patthananb/ECE_Openhouse_Souvenir/docs/placement_bottom.png

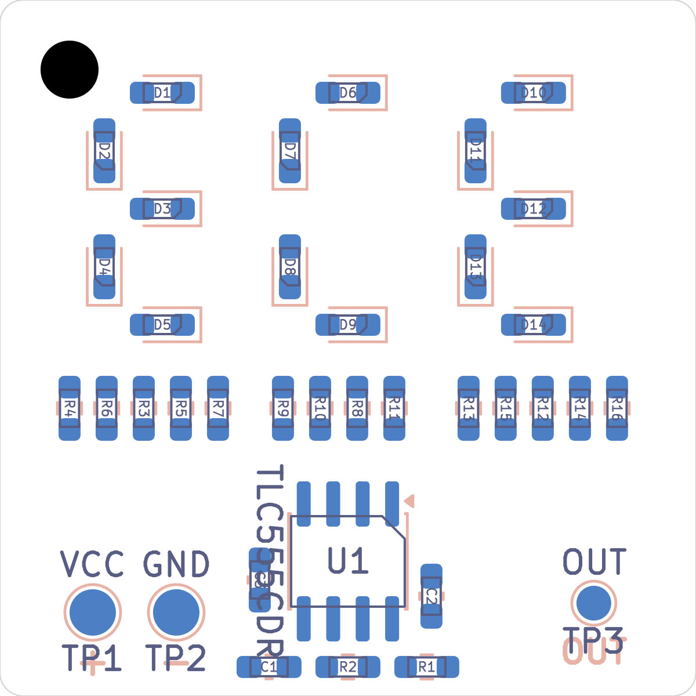
docs/placement_bottom.png
