patthananb/ECE_Openhouse_Souvenir/docs/placement_top.png

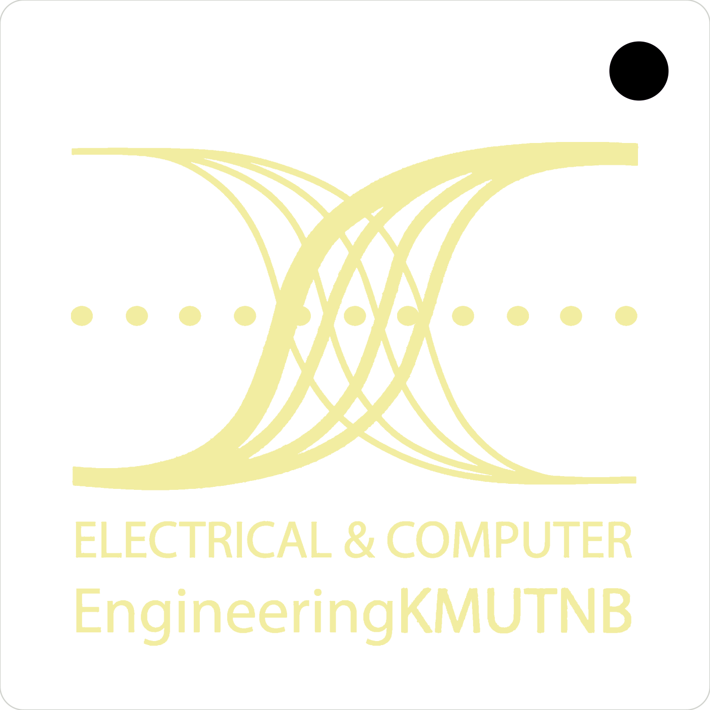
docs/placement_top.png
