patthananb/ECE_Openhouse_Souvenir/docs/routed_bottom.png

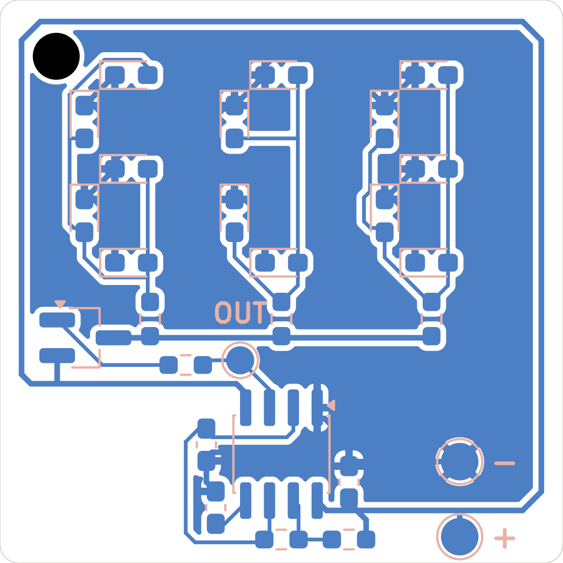
docs/routed_bottom.png
