patthananb/ECE_Openhouse_Souvenir/hardware/ece_souvenir.kicad_pcb

## KiCad design hardware/ece_souvenir.kicad_pcb (2026-10-12)

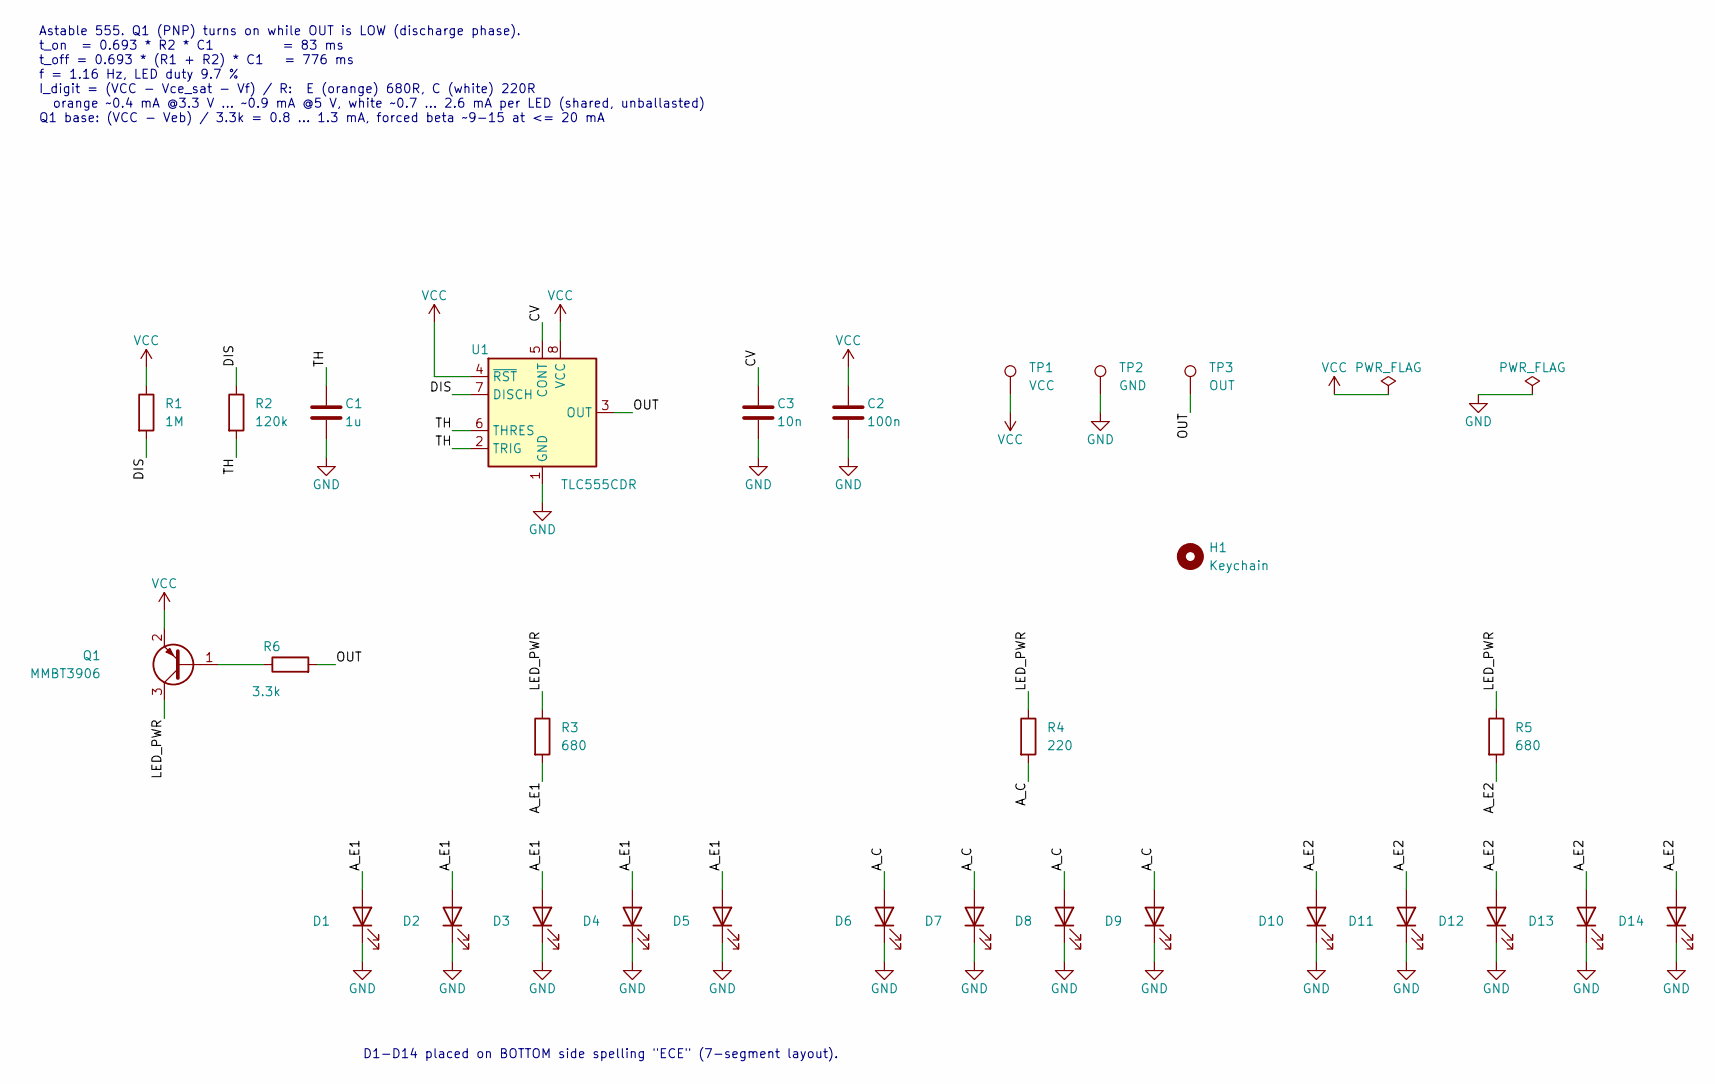
[picture p4: schematic ece_souvenir.kicad_sch, KMUTNB ECE Souvenir - ECE blinker]

Parts:
C1: 1u; C_0603_1608Metric_Pad1.08x0.95mm_HandSolder; MPN CC0603KRX7R7BB105; LCSC C106248
C2: 100n; C_0603_1608Metric_Pad1.08x0.95mm_HandSolder; MPN CC0603KRX7R9BB104; LCSC C14663
C3: 10n; C_0603_1608Metric_Pad1.08x0.95mm_HandSolder; MPN 0603B103K500NT; LCSC C57112
D1, D2, D3, D4, D5, D10, D11, D12, D13, D14: Orange; LED_0603_1608Metric_Pad1.05x0.95mm_HandSolder; MPN XL-1608UOC-06; LCSC C965800
D6, D7, D8, D9: White; LED_0603_1608Metric_Pad1.05x0.95mm_HandSolder; MPN XL-1608UWC-04; LCSC C965808
H1: Keychain; MountingHole_2.5mm
Q1: MMBT3906; SOT-23_Handsoldering; MPN MMBT3906LT1G; LCSC C53444
R1: 1M; R_0603_1608Metric_Pad0.98x0.95mm_HandSolder; MPN 0603WAF1004T5E; LCSC C22935
R2: 120k; R_0603_1608Metric_Pad0.98x0.95mm_HandSolder; MPN 0603WAF1203T5E; LCSC C25808
R3, R5: 680; R_0603_1608Metric_Pad0.98x0.95mm_HandSolder; MPN 0603WAF6800T5E; LCSC C23228
R4: 220; R_0603_1608Metric_Pad0.98x0.95mm_HandSolder; MPN 0603WAF2200T5E; LCSC C22962
R6: 3.3k; R_0603_1608Metric_Pad0.98x0.95mm_HandSolder; MPN 0603WAF3301T5E; LCSC C22978
TP1: VCC; TestPoint_Pad_D2.0mm
TP2: GND; TestPoint_Pad_D2.0mm
TP3: OUT; TestPoint_Pad_D1.5mm
U1: TLC555CDR; SOIC-8_3.9x4.9mm_P1.27mm; MPN TLC555CDR; LCSC C6986

Connections:
/A_C: D6.2 (A), D7.2 (A), D8.2 (A), D9.2 (A), R4.2
/A_E1: D1.2 (A), D2.2 (A), D3.2 (A), D4.2 (A), D5.2 (A), R3.2
/A_E2: D10.2 (A), D11.2 (A), D12.2 (A), D13.2 (A), D14.2 (A), R5.2
/CV: C3.1, U1.5 (CONT)
/DIS: R1.2, R2.1, U1.7 (DISCH)
/LED_PWR: Q1.3 (C), R3.1, R4.1, R5.1
/OUT: R6.2, TP3.1, U1.3 (OUT)
/TH: C1.1, R2.2, U1.2 (TRIG), U1.6 (THRES)
GND: C1.2, C2.2, C3.2, D1.1 (K), D2.1 (K), D3.1 (K), D4.1 (K), D5.1 (K), D6.1 (K), D7.1 (K), D8.1 (K), D9.1 (K), D10.1 (K), D11.1 (K), D12.1 (K), D13.1 (K), D14.1 (K), TP2.1, U1.1 (GND)
unnamed: Q1.1 (B), R6.1
VCC: C2.1, Q1.2 (E), R1.1, TP1.1, U1.4 (~RST), U1.8 (VCC)

Notes on the sheet:
Astable 555. Q1 (PNP) turns on while OUT is LOW (discharge phase). t_on = 0.693 * R2 * C1 = 83 ms t_off = 0.693 * (R1 + R2) * C1 = 776 ms f = 1.16 Hz, LED duty 9.7 % I_digit = (VCC - Vce_sat - Vf) / R: E (orange) 680R, C (white) 220R orange ~0.4 mA @3.3 V ... ~0.9 mA @5 V, white ~0.7 ... 2.6 mA per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
D1-D14 placed on BOTTOM side spelling "ECE" (7-segment layout).

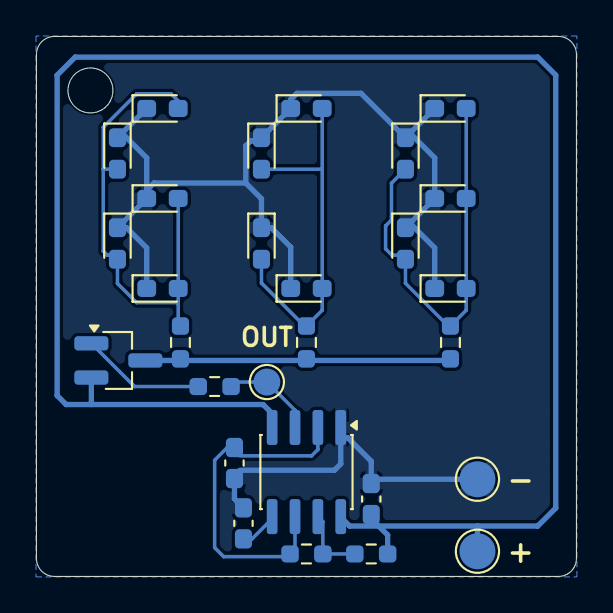
[picture p5: board ece_souvenir.kicad_pcb from below]

Board: 2 copper layers, 30.0 x 30.0 mm, 29 parts (28 on the bottom side), 11 nets.
