patthananb/ECE_Openhouse_Souvenir/(commit log)

2026-10-09 feat(sch): CMOS 555 blinker schematic with 14 LED branches
    Schematic generated from tools/parts.py by tools/gen_sch.py, upgraded
    to KiCad 10 format. ERC: 0 errors, 0 warnings. Netlist verified against
    spec by tools/check_netlist.py.
    Default parts (pending confirmation): TLC555CDR C6986, XL-1005UOC
    C965791, C1 CC0603KRX7R7BB105 C106248.
    [ece_souvenir.kicad_sch]
2026-10-09 feat(sch): pick C1 basic X5R part, add keychain hole H1, add logo art
    C1 -> C52923 (1uF 25V X5R 0402, JLC basic) instead of extended X7R to
    avoid a loading fee; temp range irrelevant for a souvenir. H1 2.5 mm
    NPTH keychain hole added so board and schematic stay in parity.
    art/ece_logo.png is the source raster for the top silkscreen.
    [ece_souvenir.kicad_sch]
2026-10-09 feat(pcb): board outline, keychain hole, logo silk and bottom placement
    30x30 mm R1 outline, 2.5 mm NPTH at (27,3). Logo traced from
    art/ece_logo.png into 48 F.SilkS polygons (24 x 21.3 mm). All parts on
    bottom: LEDs per spec 7-segment table (x mirrored), series resistors
    parallel to each LED, U1 at 270 deg with C2 1.96 mm from pin 8.
    JLCPCB rules and Power net class written to .kicad_pro.
    DRC: 0 violations, 0 parity issues, 57 unconnected (routing pending).
    [ece_souvenir.kicad_pcb, ece_souvenir.kicad_sch]
2026-10-09 feat(pcb): switch to 0603 hand-solder parts and re-place
    All parts will be hand soldered, so nothing smaller than 0603: LEDs
    XL-1608UOC-06 (C965800), passives 0603 with KiCad HandSolder footprints.
    C1 back to X7R (Yageo C106248) per the original spec now that JLC
    basic/extended fees no longer apply. Series resistors moved inside each
    digit to fit the larger 0603 courtyards.
    ERC 0, netlist OK. DRC: 0 violations, 0 parity, 57 unconnected (routing
    pending).
    [ece_souvenir.kicad_pcb, ece_souvenir.kicad_sch]
2026-10-09 feat(pcb): standalone LEDs, series resistors in a row below digits
    Per request, LEDs stand alone in the digit area. R3-R16 move to a single
    row of vertical 0603s at y=17.6 (bottom view), grouped per digit; U1 and
    timing parts shift down to the bottom edge.
    DRC: 0 violations, 0 parity, 57 unconnected (routing next).
    [ece_souvenir.kicad_pcb]
2026-10-09 feat(pcb): autoroute via Konnect + Freerouting, DRC clean
    KiCad native DSN export (bottom-side parts, roundrect pads and arc
    corners are outside Konnect's own Specctra profile) -> Konnect
    route_specctra_dsn (local Freerouting 2.4.1, JRE 25) -> KiCad SES import.
    DSN boundary inset 0.1 mm for the 0.3 mm edge rule; top-layer traces
    weighted 4-6x so the logo side carries only crossings. Freerouting
    neck-downs (0.15 mm) widened back to net-class width.
    Result: 267 mm B.Cu, 59.5 mm F.Cu, 14 tented vias.
    DRC: 0 violations, 0 unconnected, 0 schematic parity issues.
    [ece_souvenir.kicad_pcb]
2026-10-09 feat(pcb): single-sided routing, logo side copper-free
    All 334.9 mm of track on B.Cu with the parts: no F.Cu traces, no vias,
    so the top shows only the logo on white mask.
    - LED polarity 180 deg (a/g/d) / 270 deg (f/e) instead of spec 0/90:
    same look, but all cathodes meet at each digit's inner-left corner so
    sink and anode paths nest without crossing on one layer.
    - Resistor row reordered f e d g a per digit to match.
    - Router: F.Cu inactive, vias off, keepouts between LED/resistor pads
    (hand-solder bridge safety); route.py reports any between-pad
    crossing (0 on this board). Freerouting 2.4.1 drops the netlist if a
    keepout precedes autoroute_settings, so settings go first.
    DRC: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
    [ece_souvenir.kicad_pcb]
2026-10-11 chore(pcb): board moved onto drawing sheet in KiCad (user edit)
    Whole board translated by (+111.1825, +56.0585) mm; no other change
    (148 segments, 38 footprints, identical relative geometry).
    [ece_souvenir.kicad_pcb]
2026-10-11 feat(sch): PNP high-side LED driver, one resistor per digit
    Advisor review 2026-10-11:
    - Q1 MMBT3906LT1G (C53444) PNP high-side switch, base via R6 4.7k from
    555 OUT. On while OUT is LOW, so the 9.7 % flash duty is kept; the 555
    now supplies ~0.55-0.9 mA base current instead of sinking ~13 mA.
    - One current-limit resistor per digit: R3/R5 680R (E, 5 LEDs), R4 820R
    (C, 4 LEDs) = 3.3k/n, same average per-LED current. 14 -> 3 resistors.
    - LED cathodes now to GND; new nets OUT, LED_PWR, A_E1, A_C, A_E2.
    ERC 0 errors / 0 warnings; netlist matches spec (tools/check_netlist.py).
    [ece_souvenir.kicad_sch]
2026-10-11 feat(pcb): PNP driver + per-digit resistors, single-sided reroute
    Board follows the advisor-review schematic (Q1 high-side PNP, R3-R5 one
    per digit, R6 base resistor). Placement keeps the user's sheet offset
    with grid/aux origins at the board's top-left corner.
    Single-sided topology needed hand-placed, locked pre-routes
    (tools/route.py PREROUTES): TH and GND lanes under the SOIC body to its
    left end, and a VCC ring round the board edge from pin 4 to pin 8, plus
    two stubs onto it (Freerouting will not join a fixed wire mid-segment).
    Keepouts now forbid any trace between the pads of any 2-pad part.
    Result: 334.7 mm on B.Cu, 0 F.Cu, 0 vias, 0 between-pad crossings.
    DRC: 0 violations, 0 unconn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
    [ece_souvenir.kicad_pcb]
2026-10-11 feat(pcb): EMI-driven routing: 45 deg corners, 1 mm edge, GND pour
    - Corners: all pre-routes drawn at 45 deg; autorouted corners >= 90 deg
    are mitred to 45 deg after import, each miter kept only if DRC passes.
    - Edge: VCC ring moved to >= 1.0 mm from the outline, router boundary
    inset 0.5 mm, so no copper is closer than 1.0 mm to the edge.
    - B.Cu GND pour (0.3 mm clearance, thermal spokes, islands removed) for
    adjacent return paths and guarding of the high-impedance timing nodes.
    - Short explicit loops: C2 <-> U1 pin 1 GND link pre-routed; C1 moved to
    the left end of U1 between the TH and GND under-body lanes; LED_PWR is
    one straight 0.3 mm bus (LED_PWR joins the Power net class).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
    [ece_souvenir.kicad_pcb]
2026-10-12 feat: white LEDs for letter C, R4 220R, R6 3.3k
    D6-D9 -> XINGLIGHT XL-1608UWC-04 white (C965808). White Vf ~2.6 V at
    ~1 mA leaves ~0.65 V headroom at 3.3 V, so R4 drops 820R -> 220R
    (C22962) to keep C brightness close to the orange E's from 3.3 V to 5 V
    (~5-17 mcd vs ~6-14 mcd). Q1 load rises to ~19.5 mA at 5 V, so R6
    4.7k -> 3.3k (C22978) for forced beta ~9-15.
    Re-routed (same pipeline): 297.8 mm B.Cu, 0 F.Cu, 0 vias. DRC rule
    min_resolved_spokes 1 (pour is supplementary; all pads have traces).
    ERC 0/0, netlist OK, DRC 0/0/0, EMI audit PASS.
    [ece_souvenir.kicad_pcb, ece_souvenir.kicad_sch]
2026-10-12 feat: cost estimator for full assembly, DIY and bare-PCB builds
    tools/cost_estimate.py pulls live part prices (JLCPCB assembly API,
    LCSC retail API with MOQ) and applies JLCPCB Economic PCBA fees and a
    bare-PCB price model to compare the three build options at 10-500 pcs.
    README gets the resulting table and its assumptions.
